Monishkale/smart-mcb-switcher-esp32/README.md

# Smart MCB Switcher using ESP32

## Description
An IoT-based smart MCB switching and monitoring system using ESP32.

## Features
- Remote MCB switching
- ESP32-based automation
- Smart monitoring
- Email alert system

## Technologies Used
- ESP32
- Arduino IDE
- Embedded C
- IoT

## Project Files
- Main ESP32 code
- Email alert modules
- Documentation
- Project video

## Author
Monish Kale
