Monishkale/smart-mcb-switcher-esp32/ALL CODES.docx

SERVO CODE:-

#include <ESP32Servo.h>

Servo myServo;

const int servoPin = 13;

bool movementDone = true;

void setup() {

Serial.begin(115200);

myServo.attach(servoPin, 500, 2500);

myServo.write(60);

Serial.println("MG996R ready. Default=60°. '1'=180°→60°, '2'=0°→60°");

}

void loop() {

if (Serial.available() && movementDone) {

String input = Serial.readStringUntil('\n');

input.trim();

if (input == "1") {

movementDone = false;

Serial.println("MG996R: 60° → 180° → 60°");

myServo.write(165);

delay(500);

Serial.println("Returning to 60°...");

myServo.write(60);

delay(500);

movementDone = true;

Serial.println("Cycle 1 complete. Send '1' or '2'.");

}

else if (input == "2") {

movementDone = false;

Serial.println("MG996R: 60° → 0° → 60°");

myServo.write(0);

delay(500);

Serial.println("Returning to 60°...");

myServo.write(60);

delay(500);

movementDone = true;

Serial.println("Cycle 2 complete. Send '1' or '2'.");

}

}

}

HALL SENSOR CODE:-

const int hallPin = 4;

void setup() {

pinMode(hallPin, INPUT_PULLUP);

Serial.begin(115200);

Serial.println("ESP32 Hall Sensor Monitor Started");

Serial.println("Bring magnet near sensor to test");

}

void loop() {

int state = digitalRead(hallPin);

if (state == HIGH) {

Serial.println("HIGH - Magnetic field detected");

} else {

Serial.println("LOW - No magnetic field");

}

delay(500); }

MAIL SENDING CODE VIA ESP32:-

#include <Arduino.h>

#include <WiFi.h>

#include <ESP_Mail_Client.h>

#define WIFI_SSID "Mak"

#define WIFI_PASSWORD "monish123"

#define SMTP_HOST "smtp.gmail.com"

#define SMTP_PORT 465

#define AUTHOR_EMAIL "esp32.email.sending@gmail.com"

#define AUTHOR_PASSWORD "hzpiudanuiuxfxdk"

#define RECIPIENT_EMAIL "monishanandkale@gmail.com"

SMTPSession smtp;

void smtpCallback(SMTP_Status status);

void setup(){

Serial.begin(115200);

Serial.println();

WiFi.begin(WIFI_SSID, WIFI_PASSWORD);

Serial.print("Connecting to Wi-Fi");

while (WiFi.status() != WL_CONNECTED){

Serial.print(".");

delay(300);

}

Serial.println();

Serial.print("Connected with IP: ");

Serial.println(WiFi.localIP());

Serial.println();

MailClient.networkReconnect(true);

smtp.debug(1);

smtp.callback(smtpCallback);

Session_Config config;

config.server.host_name = SMTP_HOST;

config.server.port = SMTP_PORT;

config.login.email = AUTHOR_EMAIL;

config.login.password = AUTHOR_PASSWORD;

config.login.user_domain = "";

config.time.ntp_server = F("pool.ntp.org,time.nist.gov");

config.time.gmt_offset = 5.5 * 3600;

config.time.day_light_offset = 0;

SMTP_Message message;

message.sender.name = F("ESP32 ALERT SYSTEM");

message.sender.email = AUTHOR_EMAIL;

message.subject = F("⚠ Power Disconnected Alert");

message.addRecipient(F("Sara"), RECIPIENT_EMAIL);

String textMsg = "Alert!\nPower supply has been disconnected.";

message.text.content = textMsg.c_str();

message.text.charSet = "us-ascii";

message.text.transfer_encoding = Content_Transfer_Encoding::enc_7bit;

message.priority = esp_mail_smtp_priority::esp_mail_smtp_priority_low;

message.response.notify = esp_mail_smtp_notify_success | esp_mail_smtp_notify_failure | esp_mail_smtp_notify_delay;

if (!smtp.connect(&config)){

ESP_MAIL_PRINTF("Connection error, Status Code: %d, Error Code: %d, Reason: %s", smtp.statusCode(), smtp.errorCode(), smtp.errorReason().c_str());

return;

}

if (!smtp.isLoggedIn()){

Serial.println("\nNot yet logged in.");

}

else{

if (smtp.isAuthenticated())

Serial.println("\nSuccessfully logged in.");

else

Serial.println("\nConnected with no Auth.");

}

if (!MailClient.sendMail(&smtp, &message))

ESP_MAIL_PRINTF("Error, Status Code: %d, Error Code: %d, Reason: %s", smtp.statusCode(), smtp.errorCode(), smtp.errorReason().c_str());

}

void loop(){

}

void smtpCallback(SMTP_Status status){

Serial.println(status.info());

if (status.success()){

Serial.println("----------------");

ESP_MAIL_PRINTF("Message sent success: %d\n", status.completedCount());

ESP_MAIL_PRINTF("Message sent failed: %d\n", status.failedCount());

Serial.println("----------------\n");

for (size_t i = 0; i < smtp.sendingResult.size(); i++)

{

SMTP_Result result = smtp.sendingResult.getItem(i);

ESP_MAIL_PRINTF("Message No: %d\n", i + 1);

ESP_MAIL_PRINTF("Status: %s\n", result.completed ? "success" : "failed");

ESP_MAIL_PRINTF("Date/Time: %s\n", MailClient.Time.getDateTimeString(result.timestamp, "%B %d, %Y %H:%M:%S").c_str());

ESP_MAIL_PRINTF("Recipient: %s\n", result.recipients.c_str());

ESP_MAIL_PRINTF("Subject: %s\n", result.subject.c_str());

}

Serial.println("----------------\n");

smtp.sendingResult.clear();

}

}

GLOBAL MAIL SENDING CODE VIA ESP32:-

#include <WiFi.h>

#include <ESP_Mail_Client.h>

const char* ssid = "Anujs25";

const char* password = "1234567890";

WiFiServer server(80);

#define SMTP_HOST "smtp.gmail.com"

#define SMTP_PORT 465

#define AUTHOR_EMAIL "esp32.email.sending@gmail.com"

#define AUTHOR_PASSWORD "hzpiudanuiuxfxdk"

#define RECIPIENT_EMAIL "monishanandkale@gmail.com"

bool mailSent = false;

void sendEmail() {

SMTPSession smtp;

Session_Config config;

config.server.host_name = SMTP_HOST;

config.server.port = SMTP_PORT;

config.login.email = AUTHOR_EMAIL;

config.login.password = AUTHOR_PASSWORD;

config.time.ntp_server = F("pool.ntp.org");

config.time.gmt_offset = 5.5 * 3600;

SMTP_Message message;

message.sender.name = "Miniature Circuit Breaker";

message.sender.email = AUTHOR_EMAIL;

message.subject = "MCB SWITCHED OFF";

message.addRecipient("User", RECIPIENT_EMAIL);

message.text.content = "ALERT! POWER SUPPLY HAS BEEN DISCONNECTED";

if (smtp.connect(&config)) {

MailClient.sendMail(&smtp, &message);

Serial.println("✅ Email sent");

}

}

void setup() {

Serial.begin(115200);

WiFi.begin(ssid, password);

while (WiFi.status() != WL_CONNECTED) {

delay(500);

Serial.print(".");

}

Serial.println("\nConnected");

Serial.println(WiFi.localIP());

server.begin();

Serial.println("HTTP server started");

}

void loop() {

WiFiClient client = server.available();

if (!client) return;

Serial.println("⚡ Client connected");

String header = "";

while (client.connected()) {

if (client.available()) {

char c = client.read();

header += c;

Serial.write(c);

if (c == '\n') {

if (header.indexOf("GET /?pin=1") >= 0) {

Serial.println("🔔 ON detected");

mailSent = false;

}

if (header.indexOf("GET /?pin=0") >= 0 && !mailSent) {

Serial.println("🔕 OFF detected");

sendEmail();

mailSent = true;

}

client.println("HTTP/1.1 200 OK");

client.println("Connection: close");

client.println();

break;

}

}

}

client.stop();

Serial.println("🔌 Client disconnected");

}

GLOBALLY CONTROLLING SERVO MOTOR CODE:-

#include <WiFi.h>

#include <ESP32Servo.h>

const char* ssid = "Anujs25";

const char* password = "1234567890";

WiFiServer server(80);

Servo myServo;

const int servoPin = 13;

bool movementDone = true;

void setup() {

Serial.begin(115200);

myServo.attach(servoPin, 500, 2500);

myServo.write(60);

Serial.println("Servo ready at 60°");

Serial.print("Connecting to WiFi");

WiFi.begin(ssid, password);

while (WiFi.status() != WL_CONNECTED) {

delay(500);

Serial.print(".");

}

Serial.println("\n✅ WiFi connected");

Serial.print("ESP32 IP: ");

Serial.println(WiFi.localIP());

server.begin();

Serial.println("🌐 HTTP server started");

}

void moveServo180() {

movementDone = false;

Serial.println("🔵 Servo: 60° → 180° → 60°");

myServo.write(165);

delay(500);

myServo.write(60);

delay(500);

movementDone = true;

Serial.println("✅ Movement 1 complete");

}

void moveServo0() {

movementDone = false;

Serial.println("🟢 Servo: 60° → 0° → 60°");

myServo.write(0);

delay(500);

myServo.write(60);

delay(500);

movementDone = true;

Serial.println("✅ Movement 2 complete");

}

void loop() {

WiFiClient client = server.available();

if (!client) return;

Serial.println("⚡ Client connected");

String request = "";

while (client.connected()) {

if (client.available()) {

char c = client.read();

request += c;

Serial.write(c);

if (c == '\n') {

if (request.indexOf("GET /?cmd=1") >= 0 && movementDone) {

moveServo180();

}

if (request.indexOf("GET /?cmd=2") >= 0 && movementDone) {

moveServo0();

}

client.println("HTTP/1.1 200 OK");

client.println("Connection: close");

client.println();

break;

}

}

}

client.stop();

Serial.println("🔌 Client disconnected");

}

HALL SENSOR MAGNET DETECTION MAIL SENDING CODE:-

#include <WiFi.h>

#include <ESP_Mail_Client.h>

/* ===== WIFI CONFIG ===== */

const char* ssid = "Anujs25";

const char* password = "1234567890";

/* ===== HALL SENSOR ===== */

const int hallPin = 12; // GPIO4

/* ===== EMAIL CONFIG ===== */

#define SMTP_HOST "smtp.gmail.com"

#define SMTP_PORT 465

#define AUTHOR_EMAIL "esp32.email.sending@gmail.com"

#define AUTHOR_PASSWORD "hzpiudanuiuxfxdk"

#define RECIPIENT_EMAIL "monishanandkale@gmail.com"

/* ===== FLAG ===== */

bool mailSent = false;

/* ===== SEND EMAIL FUNCTION ===== */

void sendEmail() {

SMTPSession smtp;

Session_Config config;

config.server.host_name = SMTP_HOST;

config.server.port = SMTP_PORT;

config.login.email = AUTHOR_EMAIL;

config.login.password = AUTHOR_PASSWORD;

config.time.ntp_server = F("pool.ntp.org");

config.time.gmt_offset = 5.5 * 3600;

SMTP_Message message;

message.sender.name = "ESP32 SENSOR ALERT";

message.sender.email = AUTHOR_EMAIL;

message.subject = "MAGNET DETECTED";

message.addRecipient("User", RECIPIENT_EMAIL);

message.text.content = "✅ Magnet detected by Hall sensor (HIGH)";

if (smtp.connect(&config)) {

if (MailClient.sendMail(&smtp, &message)) {

Serial.println("✅ Email sent");

} else {

Serial.println("❌ Email failed");

}

}

}

/* ===== SETUP ===== */

void setup() {

Serial.begin(115200);

pinMode(hallPin, INPUT_PULLUP);

Serial.print("Connecting to WiFi");

WiFi.begin(ssid, password);

while (WiFi.status() != WL_CONNECTED) {

delay(500);

Serial.print(".");

}

Serial.println("\n✅ WiFi Connected");

Serial.println(WiFi.localIP());

Serial.println("ESP32 Hall Sensor Monitor Started");

}

/* ===== LOOP ===== */

void loop() {

int state = digitalRead(hallPin);

if (state == HIGH) {

Serial.println("🔴 HIGH - Magnet not detected");

mailSent = false;

}

if (state == LOW && !mailSent) {

Serial.println("🟢 LOW - Magnet detected");

sendEmail();

mailSent = true;

mailSent = false; // reset for next detection

}

delay(500);

}

FINAL CODE WITH SERVO, HALL SENSOR AND EMAIL:-

#include <WiFi.h>

#include <ESP_Mail_Client.h>

#include <ESP32Servo.h>

/* ===== WIFI CONFIG ===== */

const char* ssid = "internet";

const char* password = "internet pass";

/* ===== WEB SERVER ===== */

WiFiServer server(80);

/* ===== HALL SENSOR ===== */

const int hallPin = 12; // GPIO4

bool mailSent = false;

/* ===== SERVO CONFIG ===== */

Servo myServo;

const int servoPin = 13;

bool movementDone = true;

/* ===== EMAIL CONFIG ===== */

#define SMTP_HOST "smtp.gmail.com"

#define SMTP_PORT 465

#define AUTHOR_EMAIL "esp32mailg@gmail.com"

#define AUTHOR_PASSWORD "mail pass"

#define RECIPIENT_EMAIL "personalmail@gmail.com"

/* ===== SEND EMAIL ===== */

void sendEmail() {

SMTPSession smtp;

Session_Config config;

config.server.host_name = SMTP_HOST;

config.server.port = SMTP_PORT;

config.login.email = AUTHOR_EMAIL;

config.login.password = AUTHOR_PASSWORD;

config.time.ntp_server = F("pool.ntp.org");

config.time.gmt_offset = 5.5 * 3600;

SMTP_Message message;

message.sender.name = "MCB SENSOR ALERT";

message.sender.email = AUTHOR_EMAIL;

message.subject = "MAGNET DETECTED";

message.addRecipient("User", RECIPIENT_EMAIL);

message.text.content = "✅ MCB HAS BEEN TRIPPED";

if (smtp.connect(&config)) {

if (MailClient.sendMail(&smtp, &message)) {

Serial.println("✅ Email sent");

} else {

Serial.println("❌ Email failed");

}

}

}

/* ===== SERVO ACTIONS ===== */

void moveServo180() {

movementDone = false;

Serial.println("🔵 Servo: 60° → 180° → 60°");

myServo.write(165);

delay(500);

myServo.write(60);

delay(500);

movementDone = true;

Serial.println("✅ Servo cycle 1 complete");

}

void moveServo0() {

movementDone = false;

Serial.println("🟢 Servo: 60° → 0° → 60°");

myServo.write(0);

delay(500);

myServo.write(60);

delay(500);

movementDone = true;

Serial.println("✅ Servo cycle 2 complete");

}

/* ===== SETUP ===== */

void setup() {

Serial.begin(115200);

pinMode(hallPin, INPUT_PULLUP);

myServo.attach(servoPin, 500, 2500);

myServo.write(60);

Serial.print("Connecting to WiFi");

WiFi.begin(ssid, password);

while (WiFi.status() != WL_CONNECTED) {

delay(500);

Serial.print(".");

}

Serial.println("\n✅ WiFi connected");

Serial.println(WiFi.localIP());

server.begin();

Serial.println("🌐 HTTP server started");

Serial.println("🧲 Hall sensor + 🌍 Servo ready");

}

/* ===== LOOP ===== */

void loop() {

/* ---- HALL SENSOR LOGIC ---- */

int hallState = digitalRead(hallPin);

if (hallState == HIGH) {

Serial.println("🟢 HIGH - Magnet detected");

mailSent = false;

}

if (hallState == LOW && !mailSent) {

Serial.println("🔴 LOW - Magnet not detected");

sendEmail();

mailSent = true;

}

/* ---- WEB SERVO CONTROL ---- */

WiFiClient client = server.available();

if (client) {

Serial.println("⚡ Web client connected");

String request = "";

while (client.connected()) {

if (client.available()) {

char c = client.read();

request += c;

Serial.write(c);

if (c == '\n') {

if (request.indexOf("GET /?cmd=1") >= 0 && movementDone) {

moveServo180();

}

if (request.indexOf("GET /?cmd=2") >= 0 && movementDone) {

moveServo0();

}

client.println("HTTP/1.1 200 OK");

client.println("Connection: close");

client.println();

break;

}

}

}

client.stop();

Serial.println("🔌 Web client disconnected");

}

delay(200);

}
