Monishkale/smart-mcb-switcher-esp32/ESP32 MAIL(1).docx

### Sending EMail via ESP32 Microcontroller

We use an ESP32 microcontroller to send an email alert when a specific condition occurs. The ESP32 connects to WiFi and uses SMTP to send an email automatically without human interaction.

Objective of the Project

- To send email alerts using ESP32
- To learn WiFi and SMTP communication

Hardware & Software Requirements

#### Hardware:

- ESP32
- WiFi connection
- Power supply

Software:

Arduino IDE
ESP32 board package
ESP Mail Client library

System Working

1. ESP32 connects to WiFi
2. SMTP server is configured
3. Sender and receiver email details are set
4. ESP32 detects the condition
5. Email is sent automatically

Problems Faced During Implementation:

1.Code Compilation Issues

2. Incorrect Configuration Information in Code

3.Understanding SMTP Configuration

### Conclusion :

The project successfully demonstrates sending email alerts using ESP32. This system can be used in many real-time monitoring applications and helps in automation and remote alerting.
