Monishkale/smart-mcb-switcher-esp32/Smart MCB Switcher Master Sheet.xlsx

Sheet: Requirement
Sr no. | Requirments
1 | sense when MCB triggers
2 | mail after triggering
3 | mechanism to turn on the MCB
4 | off the MCB when needed

Sheet: Plan
FOR | SR NO | PLAN | REASON FOR CHOOSING OR DROPING PLAN | Any image of plan
mechanism | 1 | Making proper mechanical shell to hold the MCB switch. | NOT CHOOSING THIS WAY( reasons given below)
 |  | mechanical switch part will act as a pull up switch + it will also be the part of mechanism to pull up the MCB switch | complexcity of this project
 |  | UP and down mechanism will be donw by using actuators or by simple rack and penion method. | speed of ract and penion actuators is actually low(not tested, so not having proof)
 |  | both actuators and simple rack and penion will be made by using servo moter | problem with servos torque
 | 2 | Simply attaching servo aside of the MCB using 3d printeed model, or fixing case. | REASON FOR CHOOSING(reason given below)
 |  | can only on or off the switch | easy to make
 |  |  | no complex actuatioters were needed.
 |  |  | low torque will be also efficieant to move the switch up and down.
sensing part | 1 | using methodlogy of pull up switch using two metal strips | NOT CHOOSING THIS WAY(REASON GIVEN BELOW)
 |  | when metal strips make conection between each other after mcb triping | it was more successful with 1st one machanism to on and off the circuit.
 |  | gives high value, same as a pullup circuits. | also chances of error were more because fo its mechanical part
 | 2 | using hall sensor | REASON FOR CHOOSING(reason given below)
 |  | feature also involves detecting the magnatic field. | easy and more accurate detection
 |  | magnatic field gives high and no magnatic field gives low. | also perfect sensor for only giving high and low output
 |  |  | will not disturb whole mechanism
 |  |  | easier than the pull up one idea.

Sheet: Solution Flow
Sr No | Feature | coding flow
1 | Attaching Magnet above the MCB switch.
2 | Sensing it using Hall sensor | hall sensor code
3 | if magnet gets detected value becomes high | mail sending code
4 | sending mail (alert mail) using | website code(frontend and backend)
5 | mail has website link(part of mail writing) | frontend- using java css
6 | creating website using | backend- using php(for taking senosrs value)
7 | web site has two switch(open and close) coded using Java CSS coding language.
8 | clicking open- servo moves right side puling up the switch.( servo comes back to its place)
9 | clicking close- servo moves left side throwing the servo back( servo comes back to its place)
10 | opening web site randomly and clicking close- servo moves left side and throws switch down(servo comes back to its place)

Sheet: R&D BOM
Sr No | Item | Qty | Rate (RS) | Total | Link
1 | C type 16amp MCB | 1 | 150
2 | ESP32 | 2 | 368
3 | ESP32 Cable | 2 | 300
4 | jumpers (male to female) | 3 | 100
5 | jumpers (female to female) | 3 | 100
6 | SG90 | 2 | 250
7 | MG90 | 2 | 400
8 | Nails(small size)1.36mm | 10 | 20
9 | niddle | 1 | 5
10 | moter driver(L293D) | 1 | 115
11 | N20 gare moter | 2
12 | wheel | 1 | 18
13 | MG996R | 1
14 | nails(large size)1.36mm | 10 | 10
15 | 3d printed model | 2
16 | nut and bolt M3X15 | 10 | 20
17 | Fevi-quick | 1 | 5
18 | hall sensor ICA3144 | 5 | 150
19 | Magnet | 3 | 66

Sheet: total cost of product
sr no. | product | qty | price | total
1 | esp32 | 1 | 350 | 350
2 | MG996R servo | 1 | 400 | 400
3 | A3144 hall sensor | 1 | 20 | 20
4 | jumpers y type | 2 | 10 | 20
5 | jumpers | 2 | 5 | 10
total |  |  |  | 800+cost of printing

Sheet: process documentation
sr. no | component | reason | weight lifting capicity
1 | SG90 servo | weight required to pullup the switch is 516gms but servo was not able to lift load of 230gms, two servos were destroyed while doing this. | 230gms
2 | MG90 servo | servo was able to lift max weight of 392gms, but speed was low and it failed to lift it 3rd time while testing, max weight with appropriate speed given by microcontroller it was able to lift was 298 | 348gms
3 | N20 gared moter | moter was not able to lift weight of 230gms, also stopping it at some point just like servo was alos deficult. | 230gms

Sheet: Looks
mg 90 servo rack and penion
